ostracod/breadbooster/README.md

# BreadBooster

Have you ever found yourself living in a 1950's-era house with unbalanced non-adjustable hot water radiators? What? You haven't? Well, too bad! BreadBooster is a device which blows air through your radiator when it detects that the radiator is warm. This allows the heat to dissipate faster than by convection alone. 

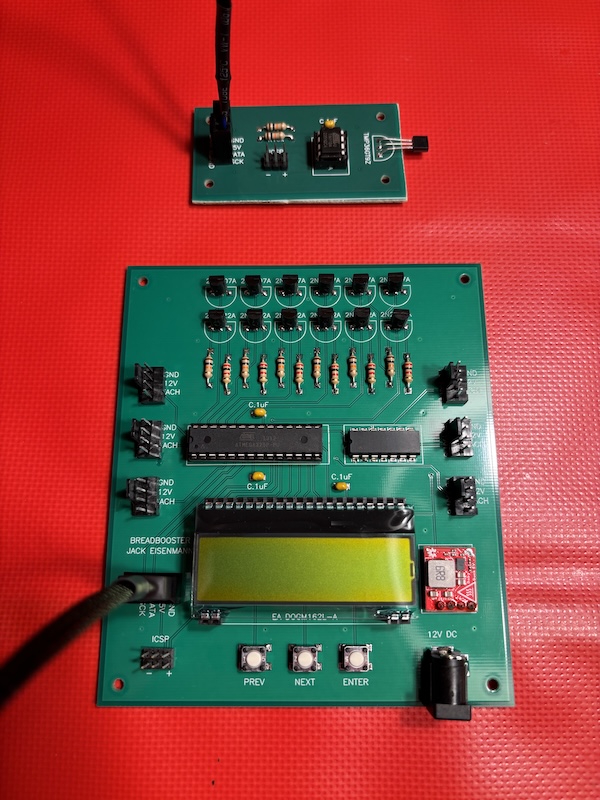
[picture p1: breadbooster.jpeg]
BreadBooster


## Parts List

BreadBooster is divided into a "main board" and a "satellite board". The satellite board measures radiator temperature and sends the measurements over a cable to the main board. The main board then decides whether to turn the fans on or off. The PCB design files are "BreadBooster main board after ground plane.pcb" and "BreadBooster satellite board after ground plane.pcb" in the "pcbFiles" directory of this repo. I used the service https://www.pad2pad.com to print the PCB.

Beyond the PCBs, BreadBooster uses these parts:

* (x1) Main microcontroller: ATMEGA328P-PU
* (x1) Satellite microcontroller: ATTINY13A-PU
* (x1) 28 pin IC socket: 1-2199298-9
* (x1) 8 pin IC socket: 1-2199298-2
* (x4) 3 pin male header: 104346-1
* (x4) 0.1 uF capacitor: K104K15X7RF5TL2
* (x1) Temperature sensor: TMP36GT9Z
* (x1) 5V step-down converter: [BabyBuck Regulator](https://www.sparkfun.com/sparkfun-babybuck-regulator-breakout-5v-ap63357.html)
* (x1) 4 pin male header: 104346-2
* (x6) NPN transistors: 2N2222A
* (x6) PNP transistors: 2N2907A
* (x1) 13 bussed 10 kOhm resistors: 4114R-2-103LF
* (x8) 10 kOhm resistor: CFR-25JB-52-10K
* (x6) 2 kOhm resistor: CFR-25JB-52-2K
* (x1) 2 x 16 character display: EA DOGM162L-A
* (x2) 2 pin female header: M20-7820246
* (x1) 20 pin female header: M20-7822046
* (x3) Button: B3F-1000
* (x1) Barrel jack connector: 694106301002
* (x2) 4 pack of 4 wire PC fan extension cables: [B0CNLDNZB2](https://www.amazon.com/Cable-Matters-4-Pack-PWM-Extension/dp/B0CNLDNZB2)
* (x7) 4 wire PC fan male connector: [CO063-B](https://www.moddiy.com/products/4184/4-Pin-3-Pin-Male-Fan-Connector-Black.html)
* (x1) 4 pin female header: M20-7820446
* (x2) 3 pack of PC fans: [B0CD7P3S8Q](https://www.amazon.com/DARKROCK-Computer-Performance-Hydraulic-Warranty/dp/B0CD7P3S8Q)
* (x1) 12V power supply: QFWB-36-12-US01

## Principles of Operation

BreadBooster has two temperature thresholds for hysteresis of fan control:

* The "on" threshold is the temperature at which the fans turn on.
* The "off" threshold is the temperature at which the fans turn off.

The default "off" and "on" thresholds are 29 &deg;C and 32 &deg;C respectively. These thresholds can be tuned using the display and buttons. It is recommended to keep these temperatures above the maximum ambient indoor summer temperature, so that the fans don't turn on unnecessarily.

BreadBooster also can detect when temperature is rapidly rising, and turn the fans on faster than the "on" threshold would otherwise allow. This type of temperature rise is called a "spike". BreadBooster has three tunables to determine spike behavior:

* "Spike width" is the window of time to check for a spike.
* "Spike height" is the minimum temperature increase to register a spike.
* "Spike reset time" is the amount of time to run the fans after a spike before reverting to normal operation.

The default spike dimensions are 5 &deg;C within 5 minutes, and the default reset time is 5 minutes.

BreadBooster saves all tunable values to internal EEPROM. This ensures that the tunables persist in the event of a power outage.

BreadBooster detects and displays the following types of faults:

* A "temperature fault" occurs when the main board is unable to communicate with the satellite board.
* A "fan fault" occurs when a fan tachometer stays flat after fan control has remained active for 10 seconds.

## Microcontroller Pinouts

Main microcontroller pinout:

* Pin 1 = PC6 = MCU reset
* Pin 2 = PD0 = Fan 2 tachometer
* Pin 3 = PD1 = Fan 1 tachometer
* Pin 4 = PD2 = Fan 3 tachometer
* Pin 5 = PD3 = Satellite clock
* Pin 6 = PD4 = Satellite data
* Pin 7 = VCC
* Pin 8 = GND
* Pin 9 = PB6 = Display reset
* Pin 10 = PB7 = Display select
* Pin 11 = PD5 = Previous button
* Pin 12 = PD6 = Next button
* Pin 13 = PD7 = Enter button
* Pin 14 = PB0 = Fan 6 tachometer
* Pin 15 = PB1 = Fan 5 tachometer
* Pin 16 = PB2 = Fan 4 tachometer
* Pin 17 = PB3 = Display data
* Pin 18 = PB4 = Display mode
* Pin 19 = PB5 = Display clock
* Pin 20 = AVCC
* Pin 21 = AREF
* Pin 22 = GND
* Pin 23 = PC0 = Fan 4 control
* Pin 24 = PC1 = Fan 5 control
* Pin 25 = PC2 = Fan 6 control
* Pin 26 = PC3 = Fan 3 control
* Pin 27 = PC4 = Fan 2 control
* Pin 28 = PC5 = Fan 1 control

Satellite microcontroller pinout:

* Pin 1 = PB5 = MCU reset
* Pin 2 = PB3 = Temperature
* Pin 3 = PB4 = Satellite clock
* Pin 4 = GND
* Pin 5 = PB0 = MCU MOSI
* Pin 6 = PB1 = Satellite data
* Pin 7 = PB2 = MCU SCK
* Pin 8 = VCC
