ostracod/breadbooster/(list of files, drawings)

Other design files:
pcbFiles/BreadBooster main board after ground plane.pcb
pcbFiles/BreadBooster main board before ground plane.pcb
pcbFiles/BreadBooster satellite board after ground plane.pcb
pcbFiles/BreadBooster satellite board before ground plane.pcb
