ostracod/breadbooster/(commit log)

2026-01-18 Test buttons and fans
2026-02-12 PCB revision 1.1
    [BreadBooster after ground plane.pcb, BreadBooster before ground plane.pcb, BreadBooster main board after ground plane.pcb, BreadBooster main board before ground plane.pcb, BreadBooster satellite board after ground plane.pcb, BreadBooster satellite board before ground plane.pcb]
2026-02-14 Improve how fan fault is detected
2026-02-18 Detect temperature spikes
2026-02-19 Fix minimum spike height
    [main.c]
2026-02-23 Fix spike reset time
    [main.c]
